Ahmed-Xavier/Echo/echo_workspace/src/ydlidar_ros2_driver/README.md

YDLIDAR

# YDLIDAR ROS2 Driver

ydlidar_ros2_driver is a new ros package, which is designed to gradually become the standard driver package for ydlidar devices in the ros2 environment.

## How to [install ROS2](https://index.ros.org/doc/ros2/Installation)
[ubuntu](https://index.ros.org/doc/ros2/Installation/Dashing/Linux-Install-Debians/)

[windows](https://index.ros.org/doc/ros2/Installation/Dashing/Windows-Install-Binary/)

## How to Create a ROS2 workspace
[Create a workspace](https://index.ros.org/doc/ros2/Tutorials/Colcon-Tutorial/#create-a-workspace)

## Build & Install YDLidar SDK

ydlidar_ros2_driver depends on YDLidar-SDK library. If you have never installed YDLidar-SDK library or it is out of date, you must first install YDLidar-SDK library. If you have installed the latest version of YDLidar-SDK, skip this step and go to the next step.

1. Download or clone the [YDLIDAR/YDLidar-SDK](https://github.com/YDLIDAR/YDLidar-SDK) repository on GitHub.
2. Compile and install the YDLidar-SDK under the ***build*** directory following `README.md` of YDLIDAR/YDLidar-SDK.

## Build ydlidar_ros2_driver

1. Clone ydlidar_ros2_driver master branch from github for old version: 

   `git clone https://github.com/YDLIDAR/ydlidar_ros2_driver.git ydlidar_ros2_ws/src/ydlidar_ros2_driver`

   Clone ydlidar_ros2_driver humble branch from github for humble,jazzy,etc: 

   `git clone -b humble https://github.com/YDLIDAR/ydlidar_ros2_driver.git ydlidar_ros2_ws/src/ydlidar_ros2_driver`

2. Build ydlidar_ros2_driver package :

   ```
   cd ydlidar_ros2_ws
   colcon build --symlink-install
   ```
   Note: install colcon [see](https://index.ros.org/doc/ros2/Tutorials/Colcon-Tutorial/#install-colcon)

   CMAKE Finished

   <font color=Red size=4>>Note: If the following error occurs, Please install  [YDLIDAR/YDLidar-SDK](https://github.com/YDLIDAR/YDLidar-SDK) first.</font>

CMAKE ERROR
   

3. Package environment setup :

   `source ./install/setup.bash`

    Note: Add permanent workspace environment variables.
    It's convenientif the ROS2 environment variables are automatically added to your bash session every time a new shell is launched:
    ```
    echo "source ~/ydlidar_ros2_ws/install/setup.bash" >> ~/.bashrc
    source ~/.bashrc
    ```
4. Confirmation
    To confirm that your package path has been set, printenv the `grep -i ROS` variable.
    ```
    printenv | grep -i ROS
    ```
    You should see something similar to:
        `OLDPWD=$YDLIDAR_WS/install`

5. Create serial port Alias [optional] 
    ```
    chmod 0777 src/ydlidar_ros2_driver/startup/*
    sudo sh src/ydlidar_ros2_driver/startup/initenv.sh
    ```
    Note: After completing the previous operation, replug the LiDAR again.
	
## Configure LiDAR [Default parameter file](params/ydlidar.yaml)

```
ydlidar_ros2_driver_node:
  ros__parameters:
    port: /dev/ttyUSB0
    frame_id: laser_frame
    ignore_array: ""
    baudrate: 230400
    lidar_type: 1
    device_type: 0
    isSingleChannel: false
    intensity: false
    intensity_bit: 0
    sample_rate: 9
    abnormal_check_count: 4
    fixed_resolution: true
    reversion: false
    inverted: false
    auto_reconnect: true
    support_motor_dtr: false
    angle_max: 180.0
    angle_min: -180.0
    range_max: 64.0
    range_min: 0.01
    frequency: 10.0
    invalid_range_is_inf: false
    debug: false
```
Note: It needs to be modified according to LiDAR actual situation.

## Run ydlidar_ros2_driver

##### Run ydlidar_ros2_driver using launch file

The command format is : 

 `ros2 launch ydlidar_ros2_driver [launch file].py`

1. Connect LiDAR uint(s).
   ```
   ros2 launch ydlidar_ros2_driver ydlidar_launch.py 
   ```
   or 

   ```
   launch $(ros2 pkg prefix ydlidar_ros2_driver)/share/ydlidar_ros2_driver/launch/ydlidar.py 
   ```
2. RVIZ 
   ```
   ros2 launch ydlidar_ros2_driver ydlidar_launch_view.py 
   ```
View
    

3. echo scan topic
   ```
   ros2 run ydlidar_ros2_driver ydlidar_ros2_driver_client or ros2 topic echo /scan
   ```

#####  Launch file introduction

The driver offers users a wealth of options when using different launch file. The launch file directory    

is `"ydlidar_ros2_ws/src/ydlidar_ros2_driver/launch"`. All launch files are listed as below : 

| launch file | features |
| --- | --- |
| ydlidar.py | Connect to defualt paramters<br/>Publish LaserScan message on `scan` topic |
| ydlidar_launch.py | Connect ydlidar.yaml Lidar specified by configuration parameters<br/>Publish LaserScan message on `scan` topic |
| ydlidar_launch_view.py | Connect ydlidar.yaml Lidar specified by configuration parameters and setup RVIZ<br/>Publish LaserScan message on `scan` topic |

## Publish Topic
| Topic | Type | Description |
|---|---|---|
| `scan` | sensor_msgs/LaserScan | 2D laser scan of the 0-angle ring |

## Subscribe Service
| Service | Type | Description |
|---|---|---|
| `stop_scan` | std_srvs::Empty | turn off lidar |
| `start_scan` | std_srvs::Empty | turn on lidar |

## Configure ydlidar_ros_driver internal parameter

The ydlidar_ros2_driver internal parameters are in the launch file, they are listed as below :

| Parameter name | Data Type | detail |
| --- | --- | --- |
| port | string | Set Lidar the serial port or IP address <br/>it can be set to `/dev/ttyUSB0`, `192.168.1.11`, etc. <br/>default: `/dev/ydlidar` |
| frame_id | string | Lidar TF coordinate system name. <br/>default: `laser_frame` |
| ignore_array | string | LiDAR filtering angle area<br/>eg: `-90, -80, 30, 40` |
| baudrate | int | Lidar baudrate or network port. <br/>default: `230400` |
| lidar_type | int | Set lidar type <br/>0 -- TYPE_TOF<br/>1 -- TYPE_TRIANGLE<br/>2 -- TYPE_TOF_NET <br/>default: `1` |
| device_type | int | Set device type <br/>0 -- YDLIDAR_TYPE_SERIAL<br/>1 -- YDLIDAR_TYPE_TCP<br/>2 -- YDLIDAR_TYPE_UDP <br/>default: `0` |
| sample_rate | int | Set Lidar Sample Rate. <br/>default: `9` |
| abnormal_check_count | int | Set the number of abnormal startup data attempts. <br/>default: `4` |
| fixed_resolution | bool | Fixed angluar resolution. <br/>default: `true` |
| reversion | bool | Reversion LiDAR. <br/>default: `true` |
| inverted | bool | Inverted LiDAR.<br/>false -- ClockWise.<br/>true -- CounterClockWise  <br/>default: `true` |
| auto_reconnect | bool | Automatically reconnect the LiDAR.<br/>true -- hot plug. <br/>default: `true` |
| isSingleChannel | bool | Whether LiDAR is a single-channel.<br/>default: `false` |
| intensity | bool | Whether LiDAR has intensity.<br/>true -- G2 LiDAR.<br/>default: `false` |
| support_motor_dtr | bool | Whether the Lidar can be started and stopped by Serial DTR.<br/>default: `false` |
| angle_min | float | Minimum Valid Angle.<br/>default: `-180` |
| angle_max | float | Maximum Valid Angle.<br/>default: `180` |
| range_min | float | Minimum Valid range.<br/>default: `0.1` |
| range_max | float | Maximum Valid range.<br/>default: `16.0` |
| frequency | float | Set Scanning Frequency.<br/>default: `10.0` |
| invalid_range_is_inf | bool | Invalid Range is inf.<br/>true -- inf.<br/>false -- 0.0.<br/>default: `false` |
More paramters details, see [here](details.md)

## Contact EAI
Development Path


If you have any extra questions, please feel free to [contact us](http://www.ydlidar.cn/cn/contact)
