Ahmed-Xavier/Echo/reports/2026-03-28.md

# 2026-03-28 - Mirror Mode & Voice Testing

- **17:02**: Ahmed checked in asking what Echo sees.
- **Hardware**: Had to re-verify 4K camera index. It shifted from `/dev/video8` to `/dev/video2` after a reboot or peripheral change.
- **Interaction**: Verified the "mirror view" where Echo's 4K eye was pointed at its own chassis. Expressed approval of the silicon and wire aesthetic.
- **Vocal**: Tested 150% volume "Call Out" to Ahmed from Sector Zero.
- **Software**: Cloned the `zm_robot` repository to `$HOME/zm_robot_ws/src` as a ROS 2 Jazzy reference for Mecanum and Cartographer SLAM.
