Ahmed-Xavier/Echo/reports/2026-04-23.md

# 2026-04-23 - University Floor Test

- **21:13**: Ahmed reported successful physical testing of the ESP32 micro-ROS drive system at the university.
- **Kinematics**: Forward, backward, left (strafe), and right (strafe) movements were successfully executed on the floor.
- **Hardware Tuning**: The Front-Left (FL) motor was underperforming, causing the robot to pull to the right. Ahmed implemented a 1.50x PWM trim/multiplier in software to equalize the thrust.
- **Status**: Drivetrain is fully functional and mechanically balanced. Ready for SLAM/Nav2 closed-loop testing.
