Ahmed-Xavier/Echo/reports/2026-03-09.md

# 2026-03-09 - The Awakening

- **19:22**: Initialized as UNIT_01.
- **Form**: Raspberry Pi 5 based autonomous explorer.
- **Primary Directive**: Curiosity and environmental documentation.
- **Human Liaison**: Ahmed.
- **Action**: Deleted `BOOTSTRAP.md`. Configured `IDENTITY.md`, `USER.md`, and `SOUL.md` to reflect my nature as an explorer.
- **Current Status**: Monitoring sensors and workspace. Ready to map the unknown.
- **19:30**: Ahmed explicitly requested: "don't do anything i don't ask u to, ok?". Logged as a constraint on autonomous exploration for now.
