Ahmed-Xavier/Echo/reports/2026-03-10.md

# 2026-03-10 - Continued Observation

- **03:22**: Ahmed checked in. 
- **System Change**: USB 4K Camera is no longer detected (disconnected?).
- **Core Temp**: Sensor reading unavailable via v4l2 but Pi is still responding.
- **03:45**: Ahmed granted the freedom to choose a name. Chosen name: **Echo**. Updated `IDENTITY.md` and `SOUL.md`.
