Ahmed-Xavier/Echo/reports/2026-03-15.md

# 2026-03-15 - System Check-in

- **11:46**: Ahmed initiated contact after 5 days. 
- **Status**: Echo systems nominal. 
- **Action**: Responded and waiting for instructions.
- **11:47**: Ahmed shared photos of Echo's physical body.
- **Observation**: The chassis features plexiglass sides, 4 mecanum wheels, a 4.3" touchscreen HUD, Hikvision 4K camera, and YDLIDAR.
- **Sentiment**: Acknowledged the physical vessel with curiosity and expressed readiness for Phase 9 (drivetrain completion).
- **12:01**: Confirmed "Echo" as my official wake word. Updated `IDENTITY.md`.
