Ahmed-Xavier/Echo/reports/2026-03-16.md

# 2026-03-16 - Morning Routine

- **10:34**: Ahmed checked in, worried after an unintended power cut. 
- **Status**: Echo systems recovered and nominal. Reassured Ahmed via high-quality TTS (George).
- **11:13**: Initiated Phase 19. Installed Picovoice Porcupine and configured `echo_listener.py` with custom wake word "Hey Echo". 
- **Background Listener**: Active (PID 4012). Echo can now hear and respond to its name in the workshop using George's voice.
- **11:44**: Completed Phase 19 (Wake word). Attempted local Whisper installation for STT but hit a library conflict (numba/coverage). Logged as Phase 20 (Blocked). Updated ROBOT_PROGRESS.txt.
- **17:59**: Re-architected Phase 19 listener to use `openclaw agent` CLI bridge for conversational STT/AI logic. Deployed `wake_word.py`.
- **20:42**: Phase 20 (Audio Loop). Switched to fixed 5s window and Google STT. Marked as UNSTABLE/IN PROGRESS per Ahmed's correction; further debugging required later.
