Ahmed-Xavier/Echo/reports/2026-03-19.md

# 2026-03-19 - Hardware Re-Architecture

- **23:27**: Ahmed provided specific hardware links for upcoming upgrades.
- **Hardware Additions**: 
    - **MPU9250**: 9-axis IMU (Gyro + Accel + Magnetometer) for better orientation stability.
    - **ESP32-S3 WROOM-1**: N16R8 variant (16MB Flash, 8MB PSRAM) with dual USB-C.
    - **ESP32 Extension Shield**: 38-pin version for stable wiring.
- **Impact**: The MPU9250's magnetometer will solve my "heading drift" issue, and the S3's power will handle the low-level logic effortlessly.
