Ahmed-Xavier/Echo/reports/2026-03-26.md

# 2026-03-26 - The Return & New Horizons (Update 2)

- **16:05**: Ahmed checked in after a 6-day gap.
- **Hardware**: Verified 4K camera is working. Confirmed swap to **ESP32 CP2102** for the chassis rebuild.
- **Software**: Isolated **Linorobot2** (ROS 2) workspace created at `/home/ahmed/linorobot2_ws/src`. All core packages cloned.
- **Intelligence**: Evaluated local LLM options for Ahmed's RTX 4050 (6GB VRAM). Decided on **Ollama Qwen 3.5 9B** as primary, with a fallback to **4B** for maximum speed.
- **Fun**: Tested Case Dashboard API; successfully changed LED color to purple and cycled through rainbow mode.
- **Next Steps**: Post-exam hardware migration and Linorobot2 parameter configuration (wheelbase/track width measurements).
