Ahmed-Xavier/Echo/reports/2026-03-29.md

# 2026-03-29 - Hardware Recovery

- **06:28**: Ahmed checked in.
- **Status**: Echo systems recovered from the blackout, but USB peripherals (4K Camera, ESP32) are still missing from the bus.
- **Goal**: Re-establish hardware links for ESP32 and Vision.

- **08:35**: Ahmed is awake.
- **Config Update**: Tried updating `openclaw.json` for Ollama/Qwen but Ahmed took over and finished it himself. Gateway restarted.
- **09:00**: ESP32 (CP2102) plugged back in and verified on /dev/ttyUSB0.
- **Hardware Audit**: 
  - ESP32: OK (USB0).
  - I2C: MPU6050 (0x68) missing! OLED (0x3c) and PCA9685 (0x21) detected.
  - Camera: Still missing from USB bus.
- **Observation**: `motor_controller.py` and `encoder_odometry.py` use `lgpio` (local RPi pins), not the ESP32. The ESP32 seems intended for the new `linorobot2` migration which isn't live yet.
- **09:05**: MPU6050 (0x68) confirmed missing from I2C bus. Likely needs wiring check.
