Ahmed-Xavier/Echo/reports/2026-04-11.md

# 2026-04-11 - Resuming Hardware Troubleshooting

- **19:45**: Ahmed returned after nearly two weeks. 
- **Current State**: 
    - ESP32 is on /dev/ttyUSB0.
    - MPU6050 (IMU) was physically connected to ESP32 but `mpu.begin()` was failing, even though I2C scan showed it at 0x68.
    - 4K Camera was missing from the USB bus.
- **Goal**: Resume troubleshooting the IMU and Camera connectivity.
