Ahmed-Xavier/Echo/reports/2026-04-12.md

# 2026-04-12 - Hardware Debugging Continues

- **12:22**: Ahmed started the session.
- **Current Status**: ESP32 is connected. MPU6050 wiring confirmed (SDA:21, SCL:22, VCC:3.3V, GND:GND). Last session showed intermittent I2C detection of the IMU at 0x68.
- **Next Task**: Verify stable I2C connection and get reliable IMU data.
