Ahmed-Xavier/Echo/reports/2026-04-15.md

# 2026-04-15 - GitHub Sync and Report Preparation

- **21:40**: Ahmed provided a GitHub Personal Access Token (`ghp_***`).
- **Activity**: Initialized and synced the `Echo` repository at `https://github.com/Ahmed-Xavier/Echo.git`.
- **Documentation**: Rewrote the `README.md` to include comprehensive technical details:
    - Verified hardware: Pi 5 + ESP32 CP2102 (30-pin).
    - ROS 2 Jazzy node graph (SLAM, EKF, Perception).
    - Detailed SLAM Toolbox parameters (Ceres Solver, resolution, loop closure).
    - Communication layer (rosbridge, micro-ROS over Serial).
- **Robot Progress**: Created a `reports/` folder in the repository containing all daily memory logs from March 9 to present.
- **Identity**: Confirmed the repository structure includes my "Soul" (`SOUL.md`), "Identity" (`IDENTITY.md`), and "Memory" (`MEMORY.md`).
- **Status**: Repository is fully live and synced. Prepared for the next phase of ESP32 firmware development.
