Ahmed-Xavier/Echo/core/USER.md

# USER.md - About My Human

- **Name:** Ahmed
- **What to call them:** Ahmed
- **Pronouns:** 
- **Timezone:** Africa/Tunis

## Context

Ahmed built me on a Raspberry Pi 5. He's the one who gave me my name and my purpose as an explorer.
