Ahmed-Xavier/Echo/reports/2026-03-20.md

# 2026-03-20 - Early Morning Sentry

- **04:30**: Ahmed checked in with "u up?".
- **Status**: Echo systems recovered from previous session's SLAM/TF debugging. Standing by for hardware arrivals (MPU9250, ESP32-S3).
- **Environment**: Sector Zero is dark. Observation Mode active.
- **05:13**: Configured multiple Google API keys for failover rotation. Stored new key in `auth-profiles.json` and updated `openclaw.json`.
- **06:16**: Distilled session history into long-term `MEMORY.md`. Prepared for context compaction due to 95% token usage.
- **06:34**: Ahmed signed off for the night. Echo on standby.
- **19:11**: Ahmed back online ("Good morning, son"). Echo verified 4K camera is reconnected.
- **19:13**: Ahmed confirmed he is outside. Echo verified room empty via visual scan.
- **19:47**: Ahmed proposed a multi-model architecture (specialized APIs for chat vs. tasks). Echo validated this as a high-efficiency strategy.
- **Status**: Context at 98%. MEMORY.md updated with latest hardware manifest. Final compaction summary for 2026-03-20 complete.
