Ahmed-Xavier/Echo/echo_runtime/report/echo_mapping_ros_graph.png

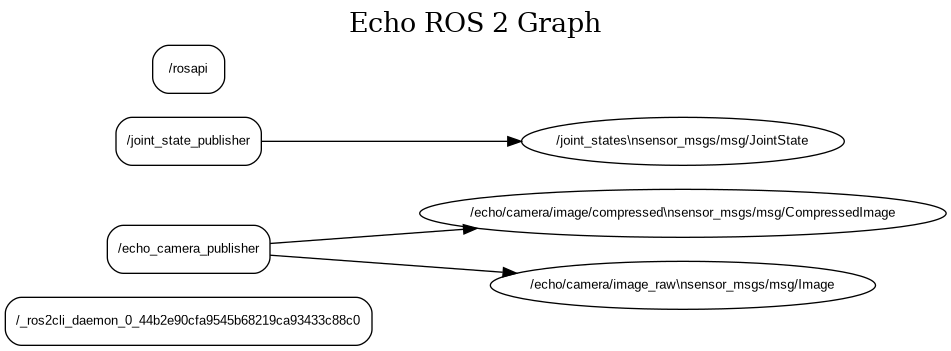
echo_runtime/report/echo_mapping_ros_graph.png
