Ahmed-Xavier/Echo/echo_workspace/src/echo_navigation/apriltags/tag36h11_0_phone.png

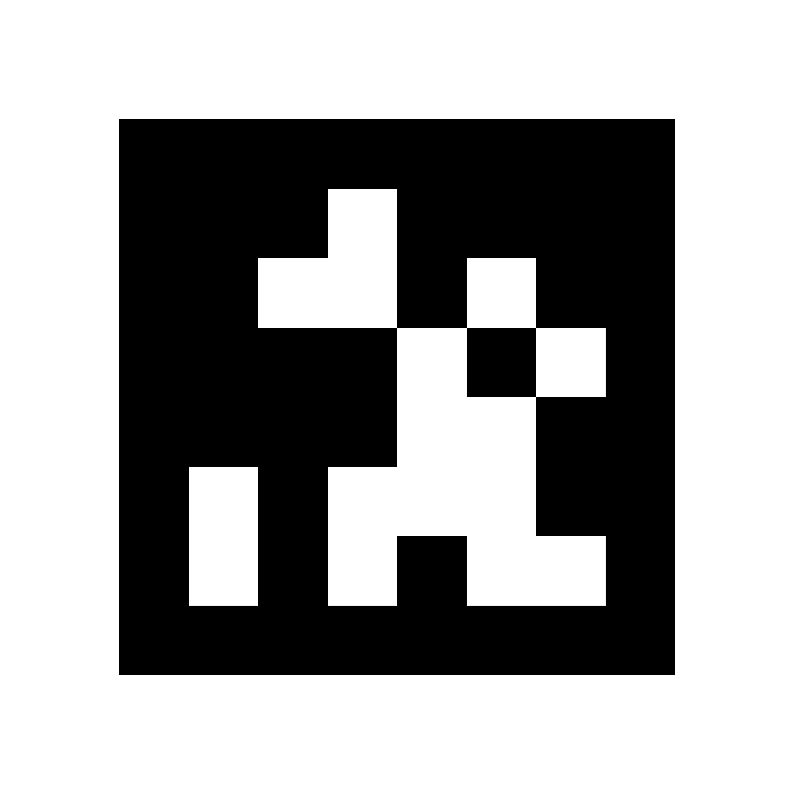
echo_workspace/src/echo_navigation/apriltags/tag36h11_0_phone.png
