Ahmed-Xavier/Echo/echo_workspace/src/echo_navigation/apriltags/tag36h11_3_phone.png

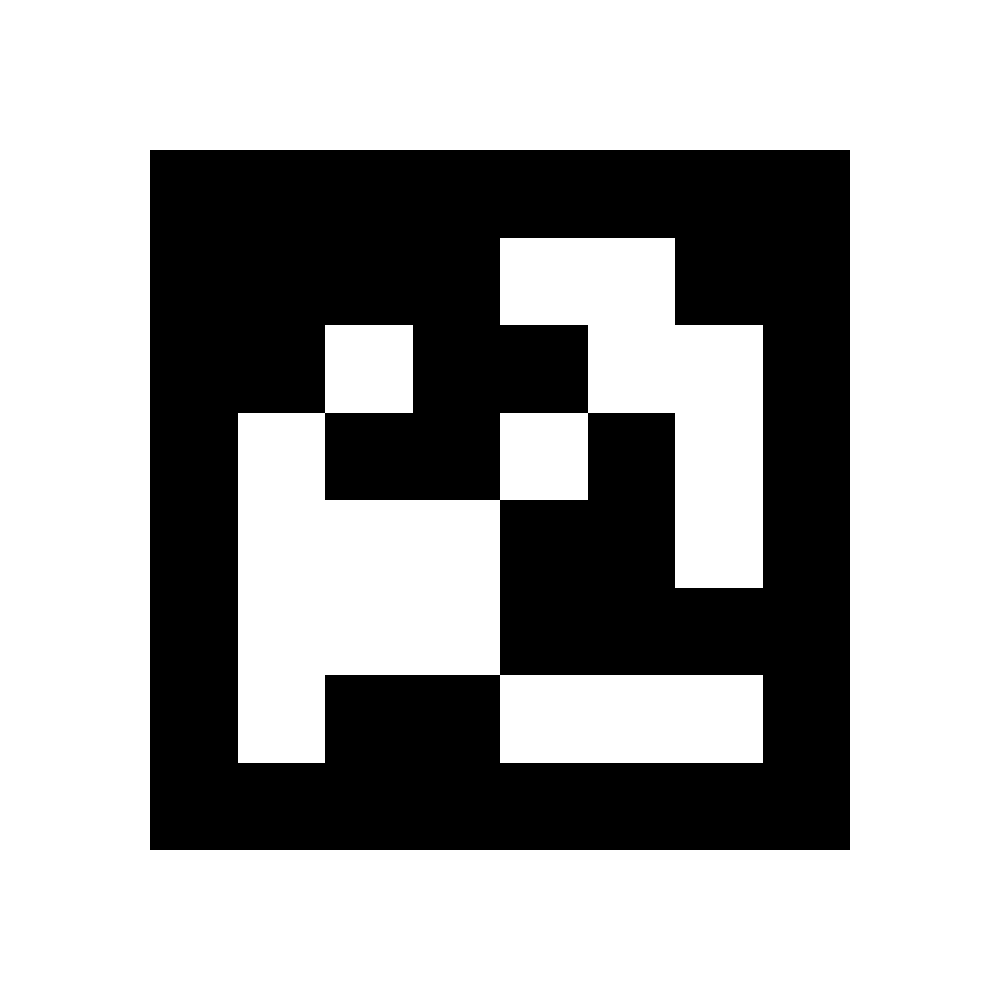
echo_workspace/src/echo_navigation/apriltags/tag36h11_3_phone.png
