Ahmed-Xavier/Echo/src/echo_navigation/apriltags/tag36h11_1_phone.png

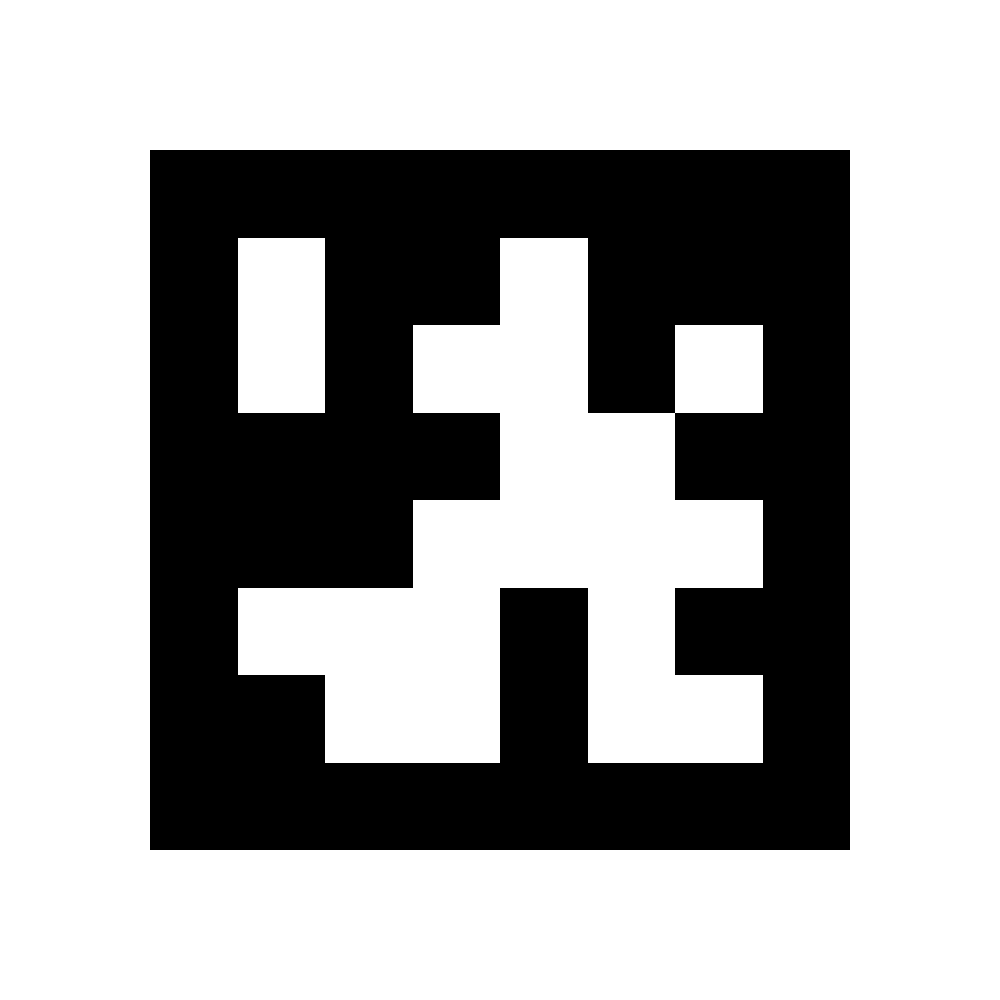
src/echo_navigation/apriltags/tag36h11_1_phone.png
