Ahmed-Xavier/Echo/src/echo_navigation/apriltags/tag36h11_2_phone.png

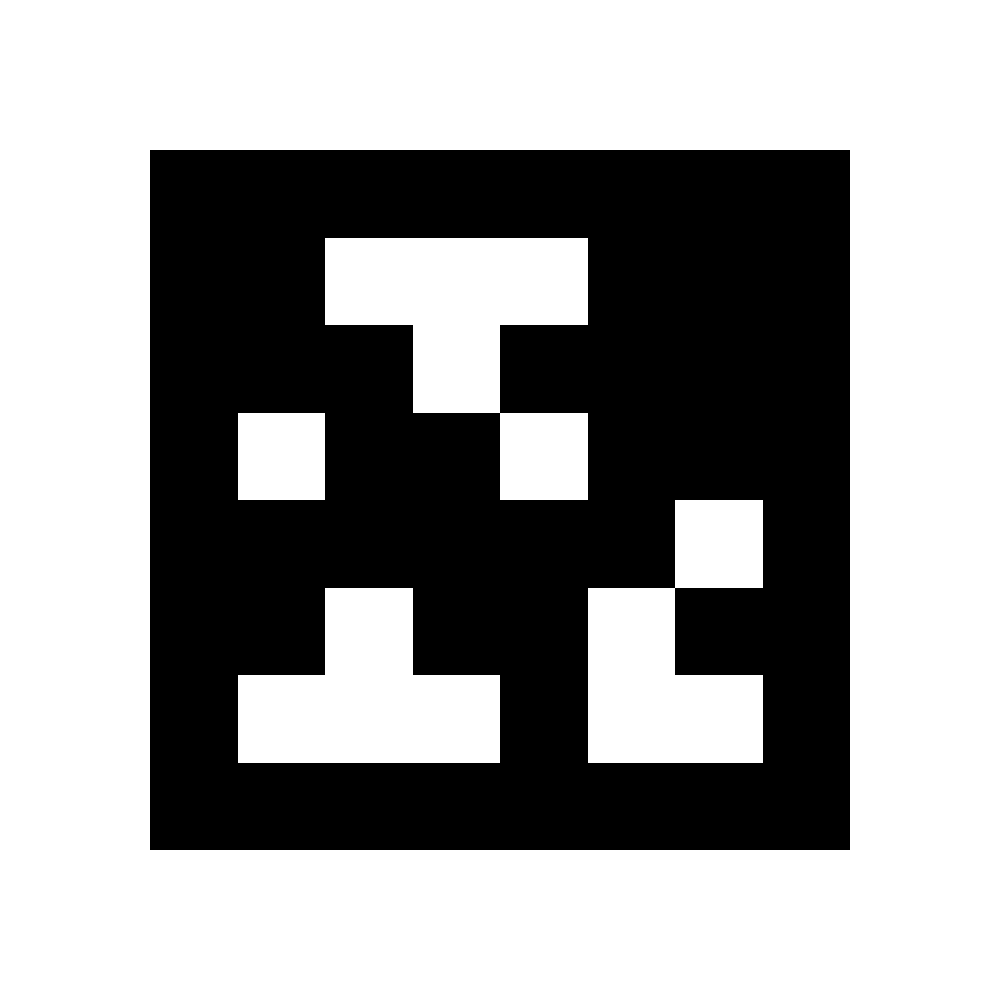
src/echo_navigation/apriltags/tag36h11_2_phone.png
