Ahmed-Xavier/Echo/src/echo_navigation/apriltags/tag36h11_4_phone.png

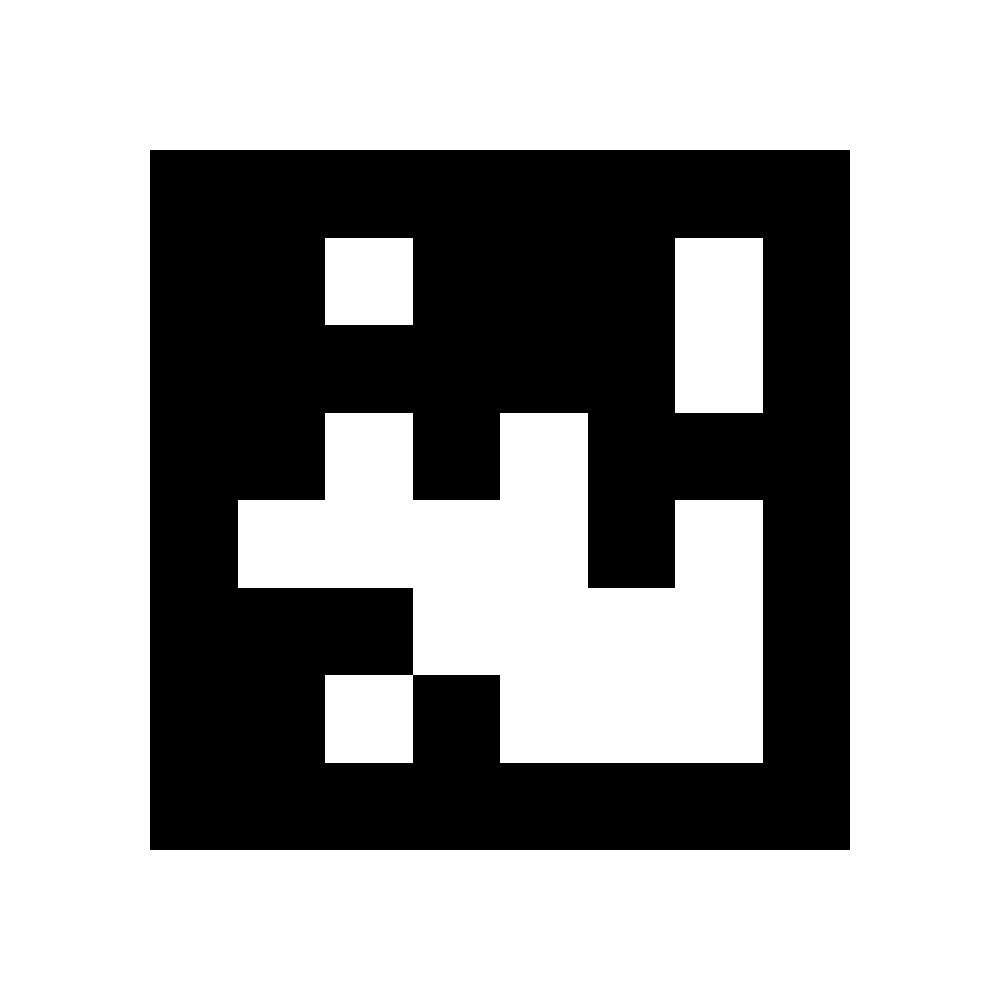
src/echo_navigation/apriltags/tag36h11_4_phone.png
