Ahmed-Xavier/Echo/wake_word.py

#!/usr/bin/env python3
import os
import re
import struct
import subprocess
import time
import wave
from pathlib import Path

import pvporcupine
import requests
import speech_recognition as sr
from pvrecorder import PvRecorder


ENV_PATH = Path(
    os.getenv(
        "ECHO_VOICE_ENV_FILE",
        str(Path.home() / "echo_workspace/echo_runtime/voice/voice.env"),
    )
)
QUERY_WAV = Path("/tmp/echo_voice_query.wav")
REPLY_MP3 = Path("/tmp/echo_voice_reply.mp3")
ACK_SOUND = Path("/usr/share/sounds/alsa/Front_Center.wav")
ANSI_RE = re.compile(r"\x1b\[[0-9;]*[A-Za-z]")


def load_env_file(path):
    if not path.exists():
        return
    for line in path.read_text().splitlines():
        line = line.strip()
        if not line or line.startswith("#") or "=" not in line:
            continue
        key, value = line.split("=", 1)
        os.environ.setdefault(key.strip(), value.strip().strip('"').strip("'"))


load_env_file(ENV_PATH)

PICOVOICE_ACCESS_KEY = os.getenv("PICOVOICE_ACCESS_KEY", "")
KEYWORD_PATH = os.getenv(
    "ECHO_KEYWORD_PATH",
    str(Path.home() / "echo_wake_word.ppn"),
)
ELEVENLABS_API_KEY = os.getenv("ELEVENLABS_API_KEY", "")
ELEVENLABS_VOICE_ID = os.getenv("ELEVENLABS_VOICE_ID", "JBFqnCBsd6RMkjVDRZzb")
OPENCLAW_AGENT = os.getenv("OPENCLAW_AGENT", "main")
OPENCLAW_THINKING = os.getenv("OPENCLAW_THINKING", "low")
TELEGRAM_ID = os.getenv("TELEGRAM_ID", "")
DEVICE_INDEX = int(os.getenv("ECHO_AUDIO_DEVICE_INDEX", "-1"))

COMMAND_SECONDS = float(os.getenv("ECHO_COMMAND_SECONDS", "6"))
SESSION_IDLE_ERRORS = int(os.getenv("ECHO_SESSION_IDLE_ERRORS", "2"))
SESSION_MAX_TURNS = int(os.getenv("ECHO_SESSION_MAX_TURNS", "20"))
MAX_SPOKEN_CHARS = int(os.getenv("ECHO_MAX_SPOKEN_CHARS", "1200"))

VOICE_ONLY_PREFIX = (
    "You are speaking through Echo the robot voice system. "
    "Do not send Telegram messages. Do not use Telegram as the answer channel. "
    "Return your final answer as plain terminal text only, because this text will be spoken aloud. "
    "Keep the answer concise. User said: "
)

SLEEP_PHRASES = (
    "go to sleep",
    "stop listening",
    "stop the conversation",
    "that's all",
    "that is all",
    "goodbye",
    "bye echo",
    "sleep echo",
)


def log(message):
    print(message, flush=True)


def require_config():
    missing = []
    if not PICOVOICE_ACCESS_KEY:
        missing.append("PICOVOICE_ACCESS_KEY")
    if not ELEVENLABS_API_KEY:
        missing.append("ELEVENLABS_API_KEY")
    if not Path(KEYWORD_PATH).exists():
        missing.append(f"ECHO_KEYWORD_PATH missing file: {KEYWORD_PATH}")
    if missing:
        raise RuntimeError("Missing voice config: " + ", ".join(missing))


def play_file(path):
    if not Path(path).exists():
        return
    try:
        subprocess.run(
            ["ffplay", "-nodisp", "-autoexit", "-loglevel", "quiet", str(path)],
            stdout=subprocess.DEVNULL,
            stderr=subprocess.DEVNULL,
            timeout=30,
        )
    except Exception as exc:
        log(f"[voice] playback skipped: {exc}")


def say(text):
    text = (text or "").strip() or "Done."

    if len(text) > MAX_SPOKEN_CHARS:
        text = text[:MAX_SPOKEN_CHARS].rsplit(" ", 1)[0] + "..."

    log(f"Echo: {text}")

    url = f"https://api.elevenlabs.io/v1/text-to-speech/{ELEVENLABS_VOICE_ID}"
    headers = {
        "xi-api-key": ELEVENLABS_API_KEY,
        "Content-Type": "application/json",
    }
    data = {
        "text": text,
        "model_id": "eleven_multilingual_v2",
    }

    try:
        resp = requests.post(url, json=data, headers=headers, timeout=60)
        if resp.status_code != 200:
            log(f"[voice] ElevenLabs error {resp.status_code}: {resp.text[:300]}")
            return
        REPLY_MP3.write_bytes(resp.content)
        play_file(REPLY_MP3)
    except Exception as exc:
        log(f"[voice] TTS error: {exc}")


def record_command(seconds=COMMAND_SECONDS):
    """
    Use a fresh PvRecorder for every spoken question.
    This avoids the old bug where Echo says 'I'm listening' and then never captures the question.
    """
    log(f"[voice] recording question for {seconds:.1f}s...")

    frames = []
    recorder = PvRecorder(device_index=DEVICE_INDEX, frame_length=512)

    try:
        recorder.start()
        deadline = time.time() + seconds
        while time.time() < deadline:
            frames.append(recorder.read())
    finally:
        try:
            recorder.stop()
        except Exception:
            pass
        recorder.delete()

    samples = [sample for frame in frames for sample in frame]

    with wave.open(str(QUERY_WAV), "wb") as wav:
        wav.setparams((1, 2, 16000, 0, "NONE", "NONE"))
        wav.writeframes(struct.pack("h" * len(samples), *samples))

    log(f"[voice] wrote command audio: {QUERY_WAV}")
    return QUERY_WAV


def transcribe(path):
    recognizer = sr.Recognizer()
    with sr.AudioFile(str(path)) as source:
        audio_data = recognizer.record(source)
    return recognizer.recognize_google(audio_data).strip()


def notify_telegram(query):
    if not TELEGRAM_ID:
        return
    try:
        subprocess.run(
            [
                "openclaw",
                "message",
                "send",
                "--target",
                f"telegram:{TELEGRAM_ID}",
                "--message",
                f'Heard: "{query}"',
            ],
            stdout=subprocess.DEVNULL,
            stderr=subprocess.DEVNULL,
            timeout=20,
        )
    except Exception as exc:
        log(f"[voice] telegram log skipped: {exc}")


def clean_openclaw_output(output):
    output = ANSI_RE.sub("", output or "").strip()
    lines = [line.rstrip() for line in output.splitlines()]
    lines = [line for line in lines if line.strip()]
    return "\n".join(lines).strip()


def ask_openclaw(query):
    log(f"User: {query}")

    voice_message = VOICE_ONLY_PREFIX + query

    try:
        result = subprocess.run(
            [
                "openclaw",
                "agent",
                "--agent",
                OPENCLAW_AGENT,
                "--message",
                voice_message,
                "--thinking",
                OPENCLAW_THINKING,
            ],
            text=True,
            stdout=subprocess.PIPE,
            stderr=subprocess.STDOUT,
            timeout=45,
        )
    except subprocess.TimeoutExpired:
        return "I took too long thinking, sorry."
    except Exception as exc:
        log(f"[voice] OpenClaw error: {exc}")
        return "I had trouble reaching OpenClaw."

    response = clean_openclaw_output(result.stdout)

    log(f"[voice] OpenClaw raw response: {response[:1000] if response else '<empty>'}")

    if result.returncode != 0:
        log(f"[voice] OpenClaw exited with code {result.returncode}: {response}")
        return "OpenClaw had an error while answering."

    if not response:
        return "I answered in Telegram, but I did not receive text to speak. The main agent is still routed to Telegram."

    # Remove common CLI noise if it appears.
    bad_prefixes = (
        "Running agent",
        "Thinking",
        "Done",
    )
    lines = []
    for line in response.splitlines():
        stripped = line.strip()
        if not stripped:
            continue
        if any(stripped.startswith(prefix) for prefix in bad_prefixes):
            continue
        lines.append(stripped)

    spoken = "\n".join(lines).strip() or response
    return spoken


def should_sleep(query):
    q = (query or "").lower().strip()
    return any(phrase in q for phrase in SLEEP_PHRASES)


def conversation_session():
    say("I'm listening.")

    idle_errors = 0

    for turn in range(SESSION_MAX_TURNS):
        log(f"[voice] session turn {turn + 1}/{SESSION_MAX_TURNS}")

        try:
            audio_path = record_command(COMMAND_SECONDS)
            query = transcribe(audio_path)
        except sr.UnknownValueError:
            idle_errors += 1
            log(f"[voice] could not understand speech; idle error {idle_errors}/{SESSION_IDLE_ERRORS}")

            if idle_errors >= SESSION_IDLE_ERRORS:
                say("I didn't hear a question, so I'll go back to sleep.")
                return

            say("I didn't catch that. Say it again.")
            continue

        except sr.RequestError as exc:
            log(f"[voice] STT request error: {exc}")
            say("I'm having trouble with speech recognition.")
            return

        except Exception as exc:
            log(f"[voice] question capture error: {exc}")
            say("I had trouble hearing the question.")
            return

        idle_errors = 0

        if should_sleep(query):
            say("Okay, going back to sleep.")
            return

        response = ask_openclaw(query)
        say(response)

    say("Session limit reached. I'll go back to sleep.")


def safe_stop(recorder):
    try:
        recorder.stop()
    except Exception:
        pass


def main():
    require_config()

    porcupine = pvporcupine.create(
        access_key=PICOVOICE_ACCESS_KEY,
        keyword_paths=[KEYWORD_PATH],
    )

    wake_recorder = PvRecorder(
        device_index=DEVICE_INDEX,
        frame_length=porcupine.frame_length,
    )

    log("[voice] Echo voice conversation online.")
    log(f"[voice] keyword: {KEYWORD_PATH}")
    log(f"[voice] audio device index: {DEVICE_INDEX}")
    log(f"[voice] command seconds: {COMMAND_SECONDS}")

    try:
        while True:
            wake_recorder.start()
            log("[voice] listening for wake word...")

            try:
                while True:
                    pcm = wake_recorder.read()
                    if porcupine.process(pcm) >= 0:
                        log("[voice] wake word detected.")
                        safe_stop(wake_recorder)

                        # Tiny pause so the mic is released before TTS/command recording.
                        time.sleep(0.25)

                        conversation_session()
                        break
            finally:
                safe_stop(wake_recorder)

    finally:
        safe_stop(wake_recorder)
        wake_recorder.delete()
        porcupine.delete()


if __name__ == "__main__":
    main()
